studiociodo/Irrigazione-LoRA/schematic/improve_efficiency.png

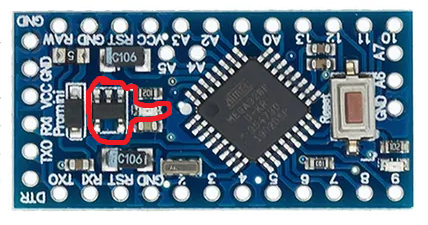
schematic/improve_efficiency.png
