studiociodo/Irrigazione-LoRA/arduino code/set ebyte module/Immagine.png

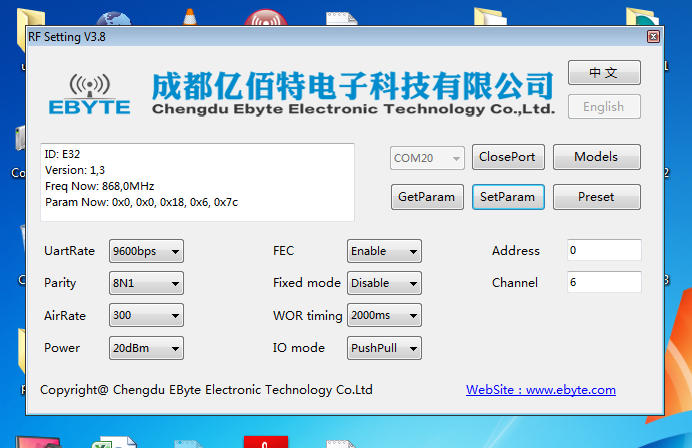
arduino code/set ebyte module/Immagine.png
