studiociodo/Irrigazione-LoRA/README.md

# Irrigazione-LoRA
A project to convert an old 24V AC irrigation control with wireless actuator

See result on Youtube (https://www.youtube.com/watch?v=jvJyAkbhIWI)
