studiociodo/Irrigazione-LoRA/schematic/collegamenti dei moduli.png

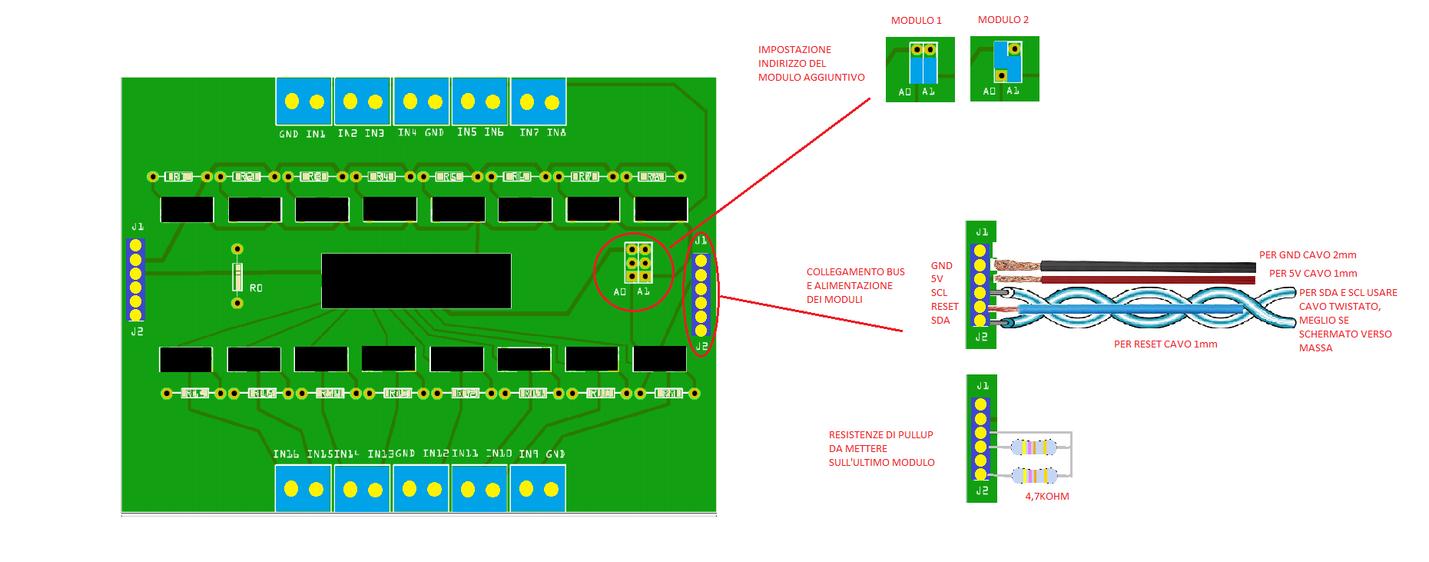
schematic/collegamenti dei moduli.png
