studiociodo/Irrigazione-LoRA/schematic/modulo mcu/modulo mcu_bb.pdf

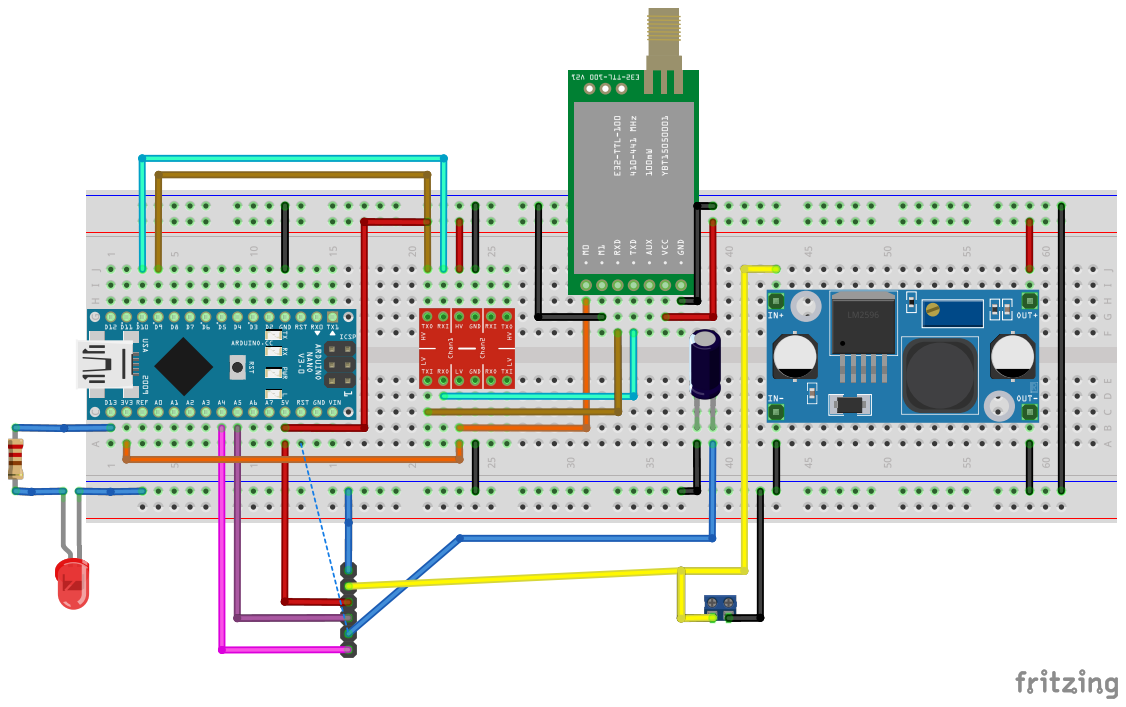
[picture p4: page 1]
