studiociodo/Irrigazione-LoRA/schematic/modulo mcu/modulo mcu_pcb.pdf

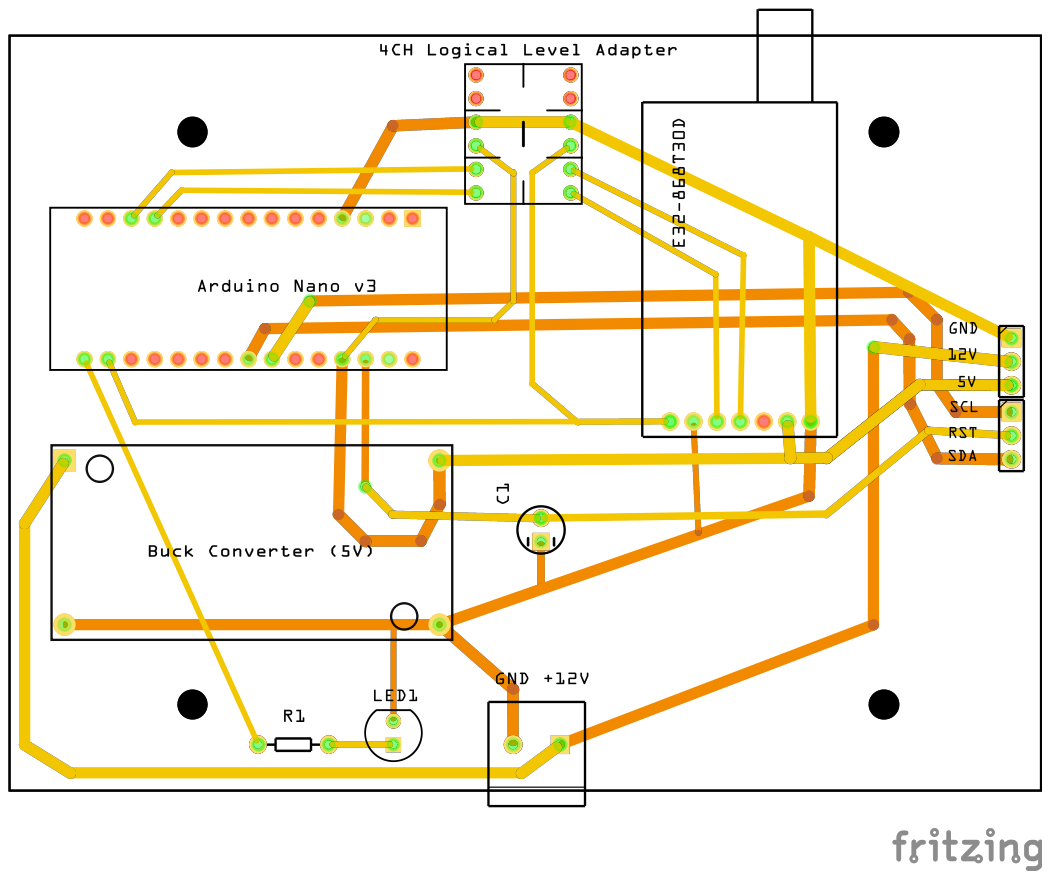
[picture p5: page 1]
