studiociodo/Irrigazione-LoRA/schematic/ricevitore/ricevitore_bb.pdf

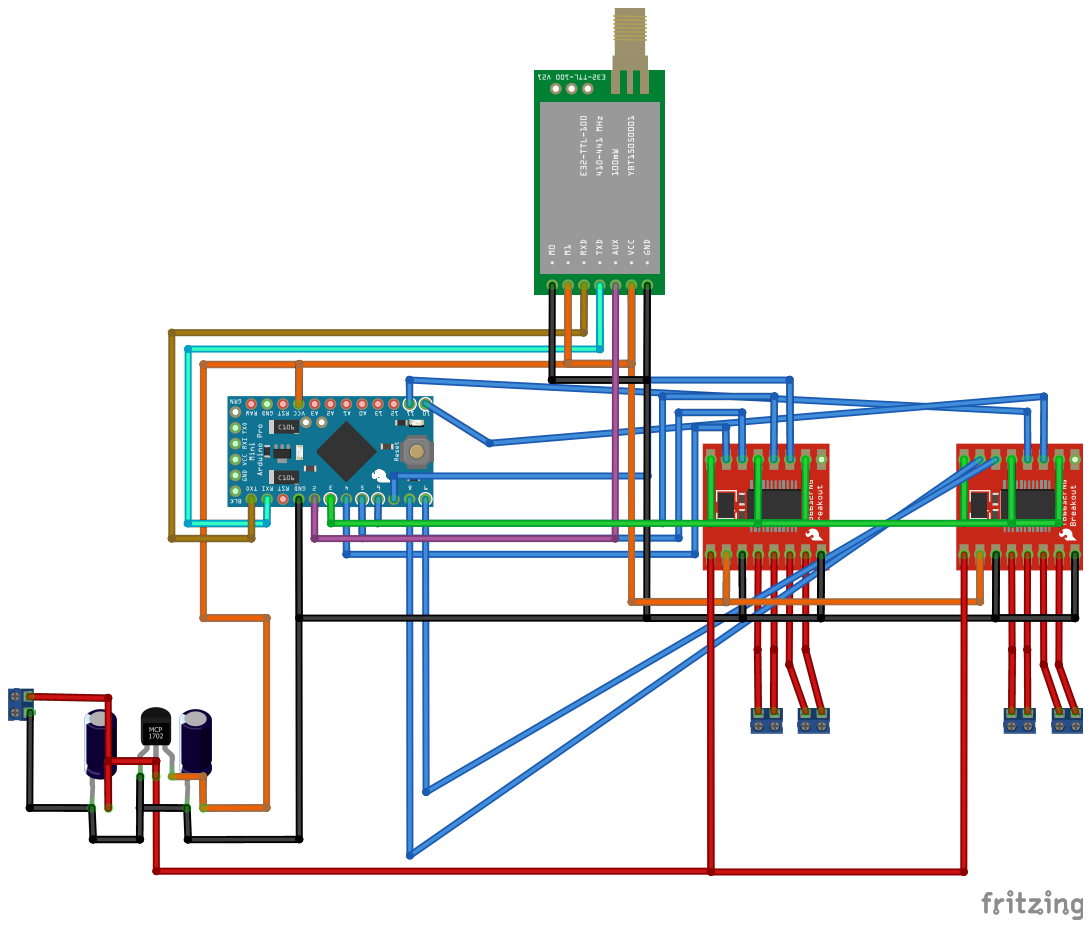
[picture p6: page 1]
