studiociodo/Irrigazione-LoRA/schematic/ricevitore/ricevitore_pcb.pdf

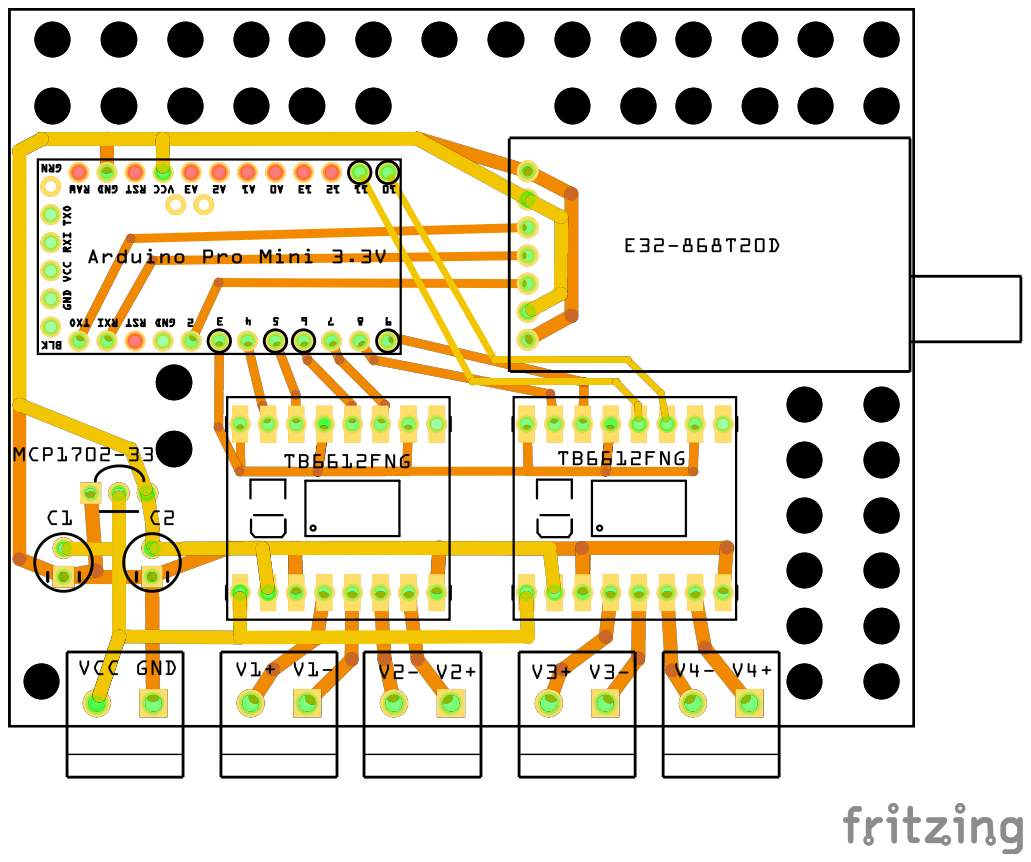
[picture p7: page 1]
