studiociodo/Irrigazione-LoRA/(list of files, drawings)

Other design files:
schematic/modulo ingressi/modulo ingressi.fzz
schematic/modulo mcu/modulo mcu.fzz
schematic/ricevitore/ricevitore.fzz
